ruthsarian/RuthsarianBladeController/images/assembled_bottom.jpg

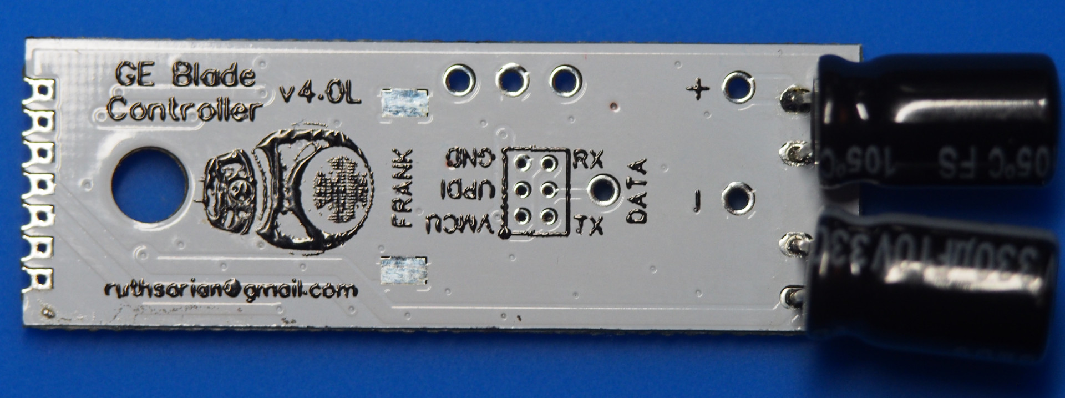
images/assembled_bottom.jpg
