ruthsarian/RuthsarianBladeController/images/assembled_top.jpg

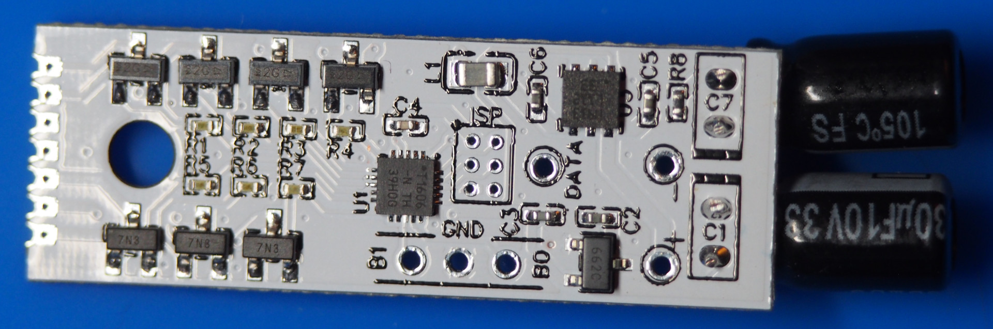
images/assembled_top.jpg
