ruthsarian/RuthsarianBladeController/images/ATtiny1606_on_pcb.jpg

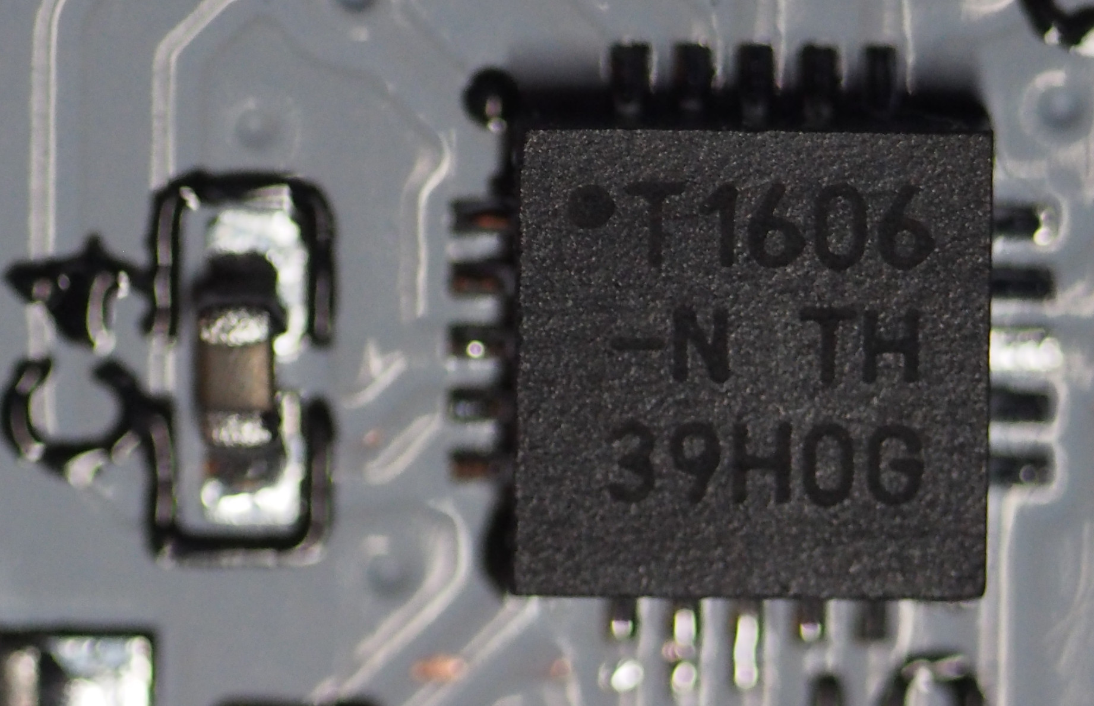
images/ATtiny1606_on_pcb.jpg
