ruthsarian/RuthsarianBladeController/images/data_pin_on_pcb.jpg

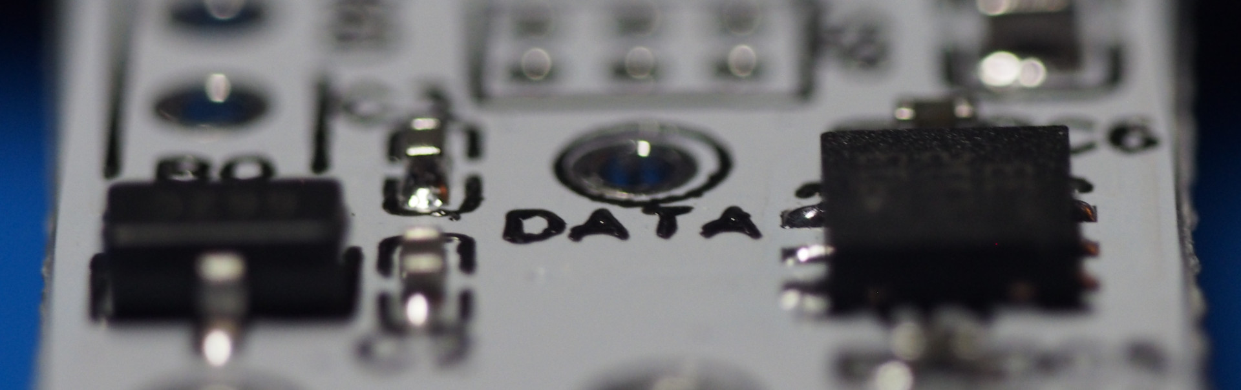
images/data_pin_on_pcb.jpg
