ruthsarian/RuthsarianBladeController/images/pcb_3d_rendering.png

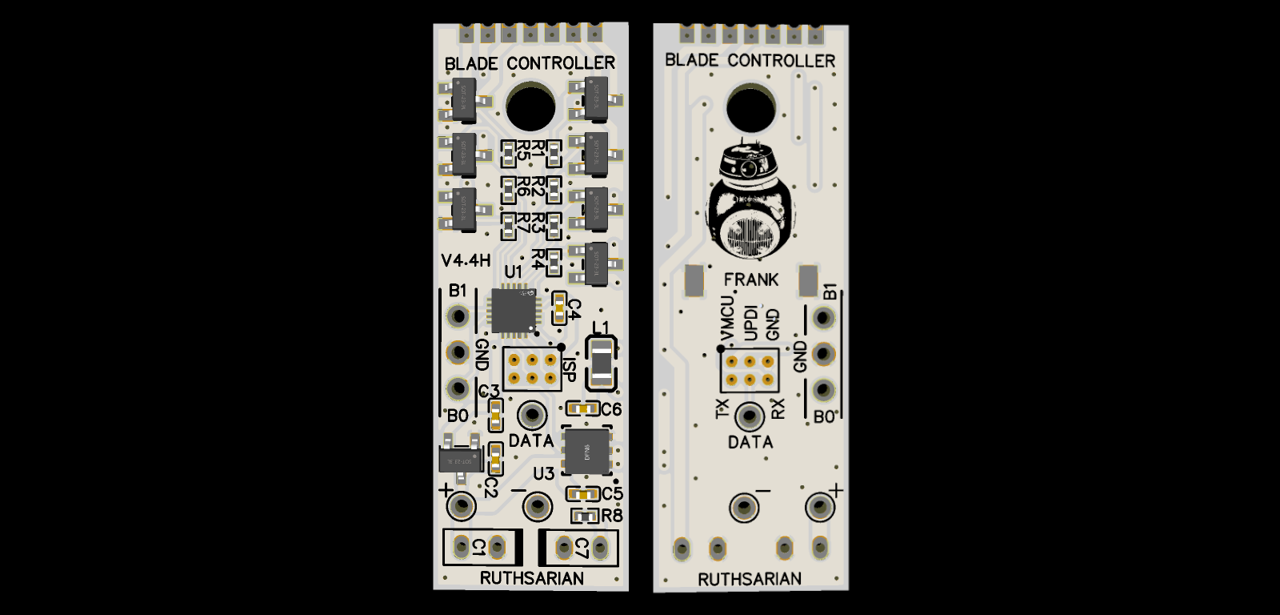
images/pcb_3d_rendering.png
