ruthsarian/RuthsarianBladeController/images/pcb_bottom.png

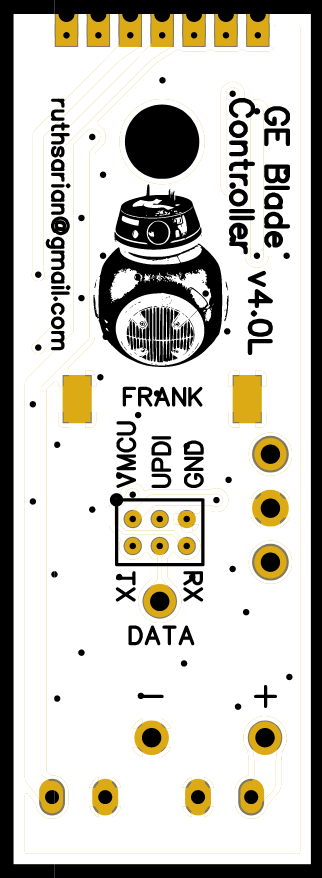
images/pcb_bottom.png
