ruthsarian/RuthsarianBladeController/images/pcb_top.png

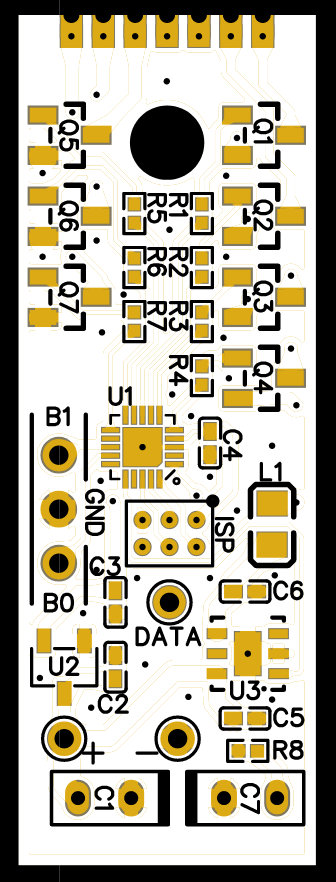
images/pcb_top.png
