ruthsarian/RuthsarianBladeController/(commit log)

2022-01-05 switch behavior fix
2022-01-05 switch behavior tweak 2
2022-01-06 reset brightness on dsubmode change
    new dsubmode was inheriting previous mode's blade brightness which resulted in some modes being dimmer than they should be.
    [blade_state.c, command_handler.c, dmode_handler.c]
2022-01-06 full brightness fix
    minor goof calling set_blade_brightness() with a value over 100. updated function so values over 100 will be treated as 100. also fixed the original call with the over 100 value. now blade ignites at 100% brightness to start unless dmode_handler() says otherwise
    [animate_handler.c, blade_state.c, command_handler.c, dmode_handler.c]
2022-01-25 Update README.md
    added BOM to README
2022-02-20 added RED_ADJUST
    RED_ADJUST is a define used to adjust the red channel's brightness down in order to simulate the series diode in the stock blade controller's red channel. this helps the blade's appear closer to stock.
2022-02-21 Update dmode_handler.c
    fixed slight error that occurs when changing brightness level during color picker mode.
    [dmode_handler.c]
2022-04-26 Update README.md
    swapped out a few components in the BOM that are end-of-life or out of stock with replacements
2022-06-21 Update README.md
    Added link to OSH Park POGO pin adapter project. Also updated to fix formatting issues introduced with Github's update to support mathematical expressions. See https://docs.github.com/en/get-started/writing-on-github/working-with-advanced-formatting/writing-mathematical-expressions
2022-06-22 Update README.md
    changed POGO adapter link to v2 of the PCB which (in theory) will be easier to assemble with a soldering iron.
2022-09-19 dcp_step_table added
    added a table where pre-calculated step values are stored. helps simplify determining the correct number of steps to take on a given value of dsubmode in the color picker. color picker is nearly there. thinking about 'white' as its own, single value, in order to gain a larger range of colors
    [blade_state.h, dmode_handler.c]
2022-09-19 but what if COLOR_PICKER_BRIGHTNESS_LEVELS = 1?
    fix so the code still works if COLOR_PICKER_BRIGHTNESS_LEVELS is set to 1.
    [blade_state.c, blade_state.h]
2022-09-19 dynamic color picker working well
    i wouldn't be surprised if i decide to tweak it further, but i like where things are at for the color picker. white is a special case now, freeing up space for more colors. having 5 brightness levels feels viable. only thing i probably will tweak a bit more is how brightness levels are calculated. a linear scale doesn't work well, so i'm trying something else.
    [dmode_handler.c, dmode_handler.h, serial.h]
2022-11-27 Updated Readme
    Updated Arduino IDE instructions to reflect changes to megaTinyCore
2023-12-28 Update README.md
    added optional DIP switch to BOM
2024-01-12 4.1 Release
    added brown-out detection and a rereading of switches on wakeup from sleep. this is to resolve problems with removing/reinserting a blade within a short time period, during which the switch configuration may have changed.
    replaced tabs with 2 spaces because whitespace is our greatest enemy.
    [RuthsarianBladeController.ino, animate_handler.c, blade_state.c, blade_state.h, command_handler.c, data.c, data.h, device_config.c]
2025-05-10 Orange Update
    Reverted the default ORANGE color for Savi's hilts. Added a new ORANGE RED color for the Baylan & Shin legacy hilts.
    [RuthsarianBladeController.ino, blade_state.c, blade_state.h]
